vbirjuko/Bargraph_thermometer/bt_term_sch.png

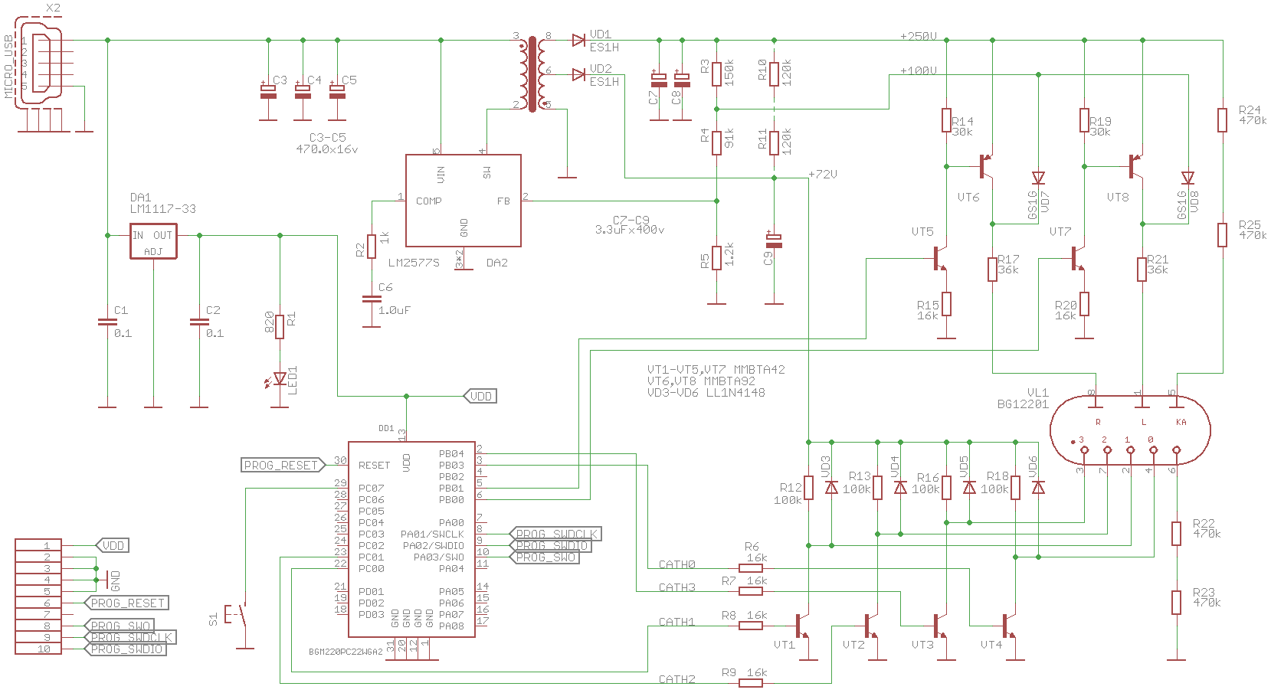
bt_term_sch.png
