vbirjuko/Bargraph_thermometer/transf.png

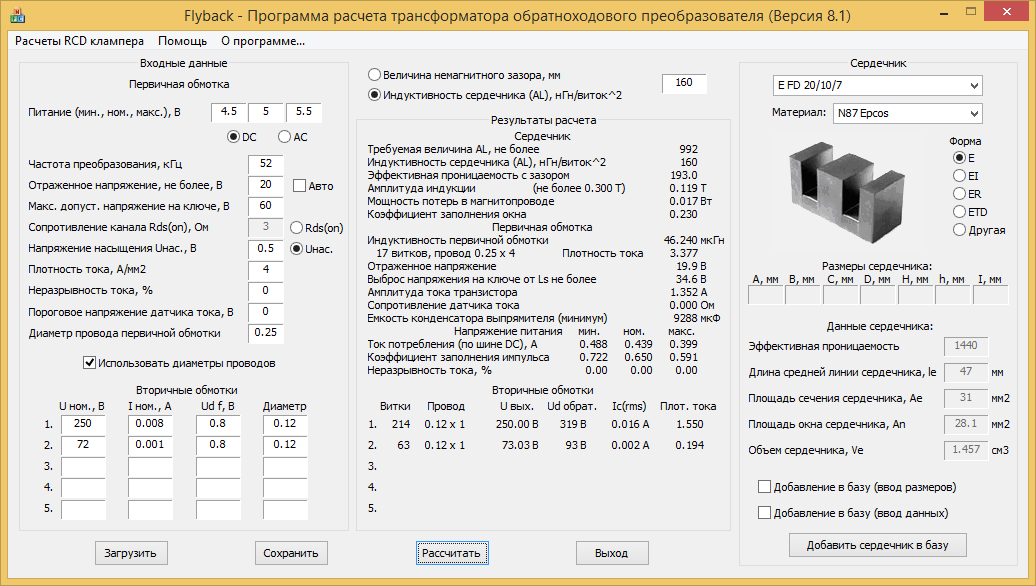
transf.png
