vbirjuko/Bargraph_thermometer/thermo_single.brd

## EAGLE design thermo_single.brd (2021-09-19)

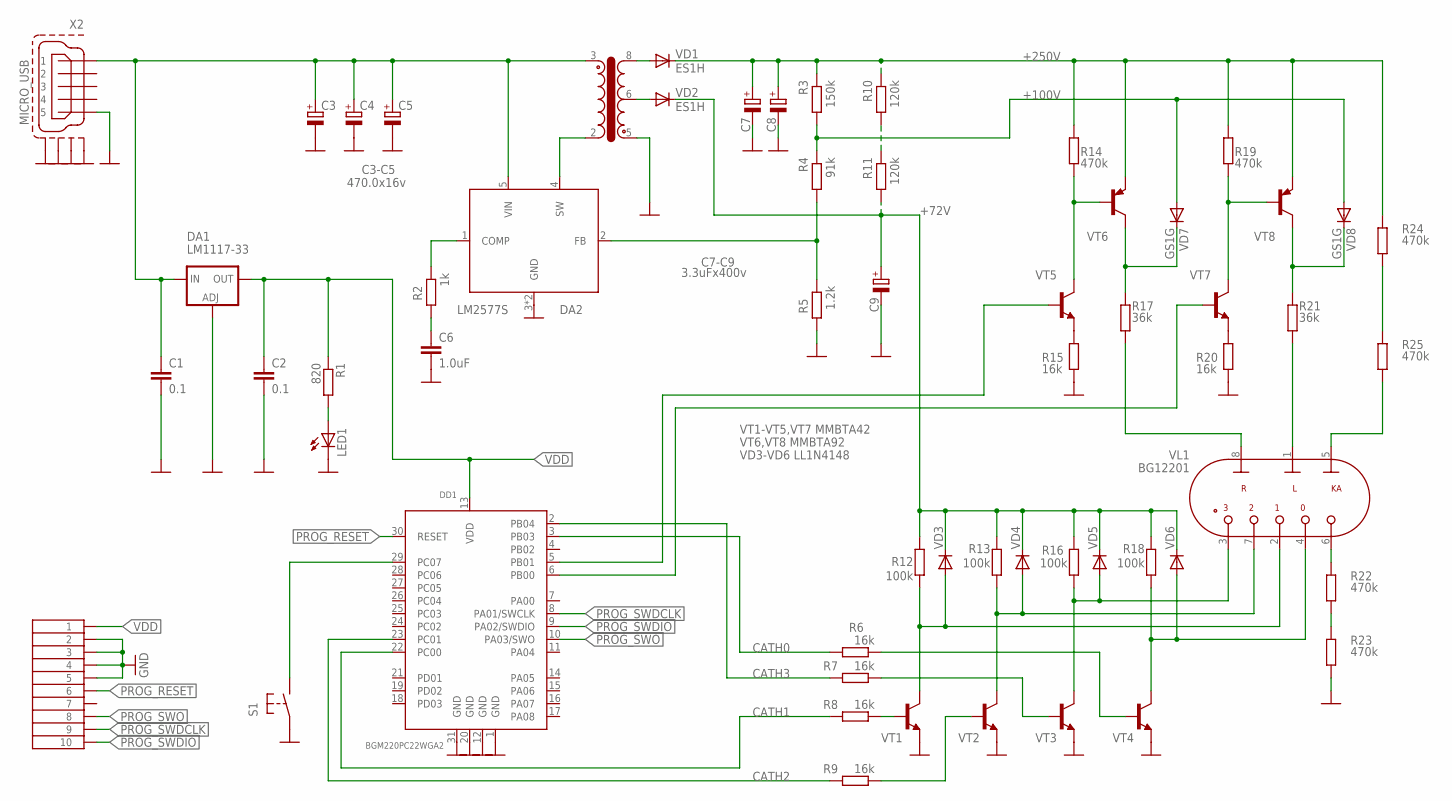
[picture p3: schematic thermo_single.sch]

Parts:
C1, C2: 0.1; C0805
C3, C4, C5: 470.0x16v; PANASONIC_G
C6: 1.0uF; C1206
C7, C8, C9: 3.3uFx400v; PANASONIC_G
DA1: LM1117-33; SOT223
DA2: LM2577S; TO263-5
DD1: BGM220PC22WGA2; BGM13P22F512GEV2
LED1: LEDP-LCC-2; P-LCC-2
R1: 820; R0805
R2: 1k; R0805
R3: 150k; R0805
R4: 91k; R0805
R5: 1.2k; R0805
R6, R7, R8, R9, R15, R20: 16k; R0805
R10, R11: 120k; R0805
R12, R13, R16, R18: 100k; R0805
R14, R19, R22, R23, R24, R25: 470k; R0805
R17, R21: 36k; R0805
S1: 10-XXPTS636SJ25; PTS636SJ25
T1: TRANSFFB; EFD20-8
VD1, VD2: ES1H; DO-214AC
VD3, VD4, VD5, VD6: LL4148; SOD80C
VD7, VD8: GS1G; DO-214AC
VL1: BG12201
VT1, VT2, VT3, VT4, VT5, VT7: mmbta42; SOT23-BEC
VT6, VT8: mmbta92; SOT23-BEC
X1: PINHEAD2X5; DS1031-08-2*5P8BS-4-1
X2: MICRO_USB; MICRO_USB_MOLEX

Connections:
+5V: C1.1, C3.+, C4.+, C5.+, DA1.3 (IN), DA2.5 (VIN), T1.3, X2.1
+72V: C9.+, R11.2, R12.2, R13.2, R16.2, R18.2, VD2.1 (C), VD3.C, VD4.C, VD5.C, VD6.C
+100V: R3.2, R4.1, VD7.2 (A), VD8.2 (A)
+250V: C7.+, C8.+, R3.1, R10.1, R14.2, R19.2, R24.2, VD1.1 (C), VT6.E, VT8.E
ANODE0: DD1.5 (PB01), VT5.B
ANODE1: DD1.6 (PB00), VT7.B
CATH0: DD1.3 (PB03), R6.2
CATH1: DD1.22 (PC00), R8.2
CATH2: DD1.23 (PC01), R9.2
CATH3: DD1.2 (PB04), R7.2
CH1ANODE: R21.1, VL1.1 (LA)
CH2ANODE: R17.1, VL1.8 (RA)
GND: C1.2, C2.2, C3.-, C4.-, C5.-, C6.2, C7.-, C8.-, C9.-, DA1.1 (ADJ), DA2.3 (GND), DA2.6 (GND), DD1.1 (GND), DD1.12 (GND), DD1.20 (GND), DD1.31 (GND), LED1.C, R5.2, R15.1, R20.1, R23.1, S1.P$1, T1.5, VT1.E, VT2.E, VT3.E, VT4.E, X1.2, X1.3, X1.4, X1.5, X2.5, X2.P$1 (S1), X2.P$2 (S2), X2.P$4 (S3), X2.P$5 (S4)
KA_ANODE: R25.1, VL1.5 (KA_A)
KEY: DD1.29 (PC07), S1.P$2 (S)
unnamed: DA2.4 (SW), T1.2
unnamed: R22.2, VL1.6 (KA_C)
unnamed: R22.1, R23.2
unnamed: DA2.2 (FB), R4.2, R5.1
unnamed: C6.1, R2.2
unnamed: DA2.1 (COMP), R2.1
unnamed: R15.2, VT5.E
unnamed: R20.2, VT7.E
unnamed: R14.1, VT5.C, VT6.B
unnamed: R10.2, R11.1
unnamed: R19.1, VT7.C, VT8.B
unnamed: R8.1, VT1.B
unnamed: R7.1, VT3.B
unnamed: R6.1, VT4.B
unnamed: R9.1, VT2.B
unnamed: R17.2, VD7.1 (C), VT6.C
unnamed: R21.2, VD8.1 (C), VT8.C
unnamed: T1.6, VD2.2 (A)
unnamed: T1.8, VD1.2 (A)
unnamed: R24.1, R25.2
unnamed: LED1.A, R1.2
PH1CATHODE: R12.1, VD3.A, VL1.2 (C1), VT1.C
PH2CATHODE: R13.1, VD4.A, VL1.7 (C2), VT2.C
PH3CATHODE: R16.1, VD5.A, VL1.3 (C3), VT3.C
PROG_RESET: DD1.30 (RESET), X1.6
PROG_SWDCLK: DD1.8 (PA01/SWCLK), X1.9
PROG_SWDIO: DD1.9 (PA02/SWDIO), X1.10
PROG_SWO: DD1.10 (PA03/SWO), X1.8
RESETCATHODE: R18.1, VD6.A, VL1.4 (CR), VT4.C
VDD: C2.1, DA1.4 (OUT), DD1.13 (VDD), R1.1, X1.1

Notes on the sheet:
C3-C5
VT1-VT5,VT7 MMBTA42
VT6,VT8 MMBTA92
C7-C9
VD3-VD6 LL1N4148

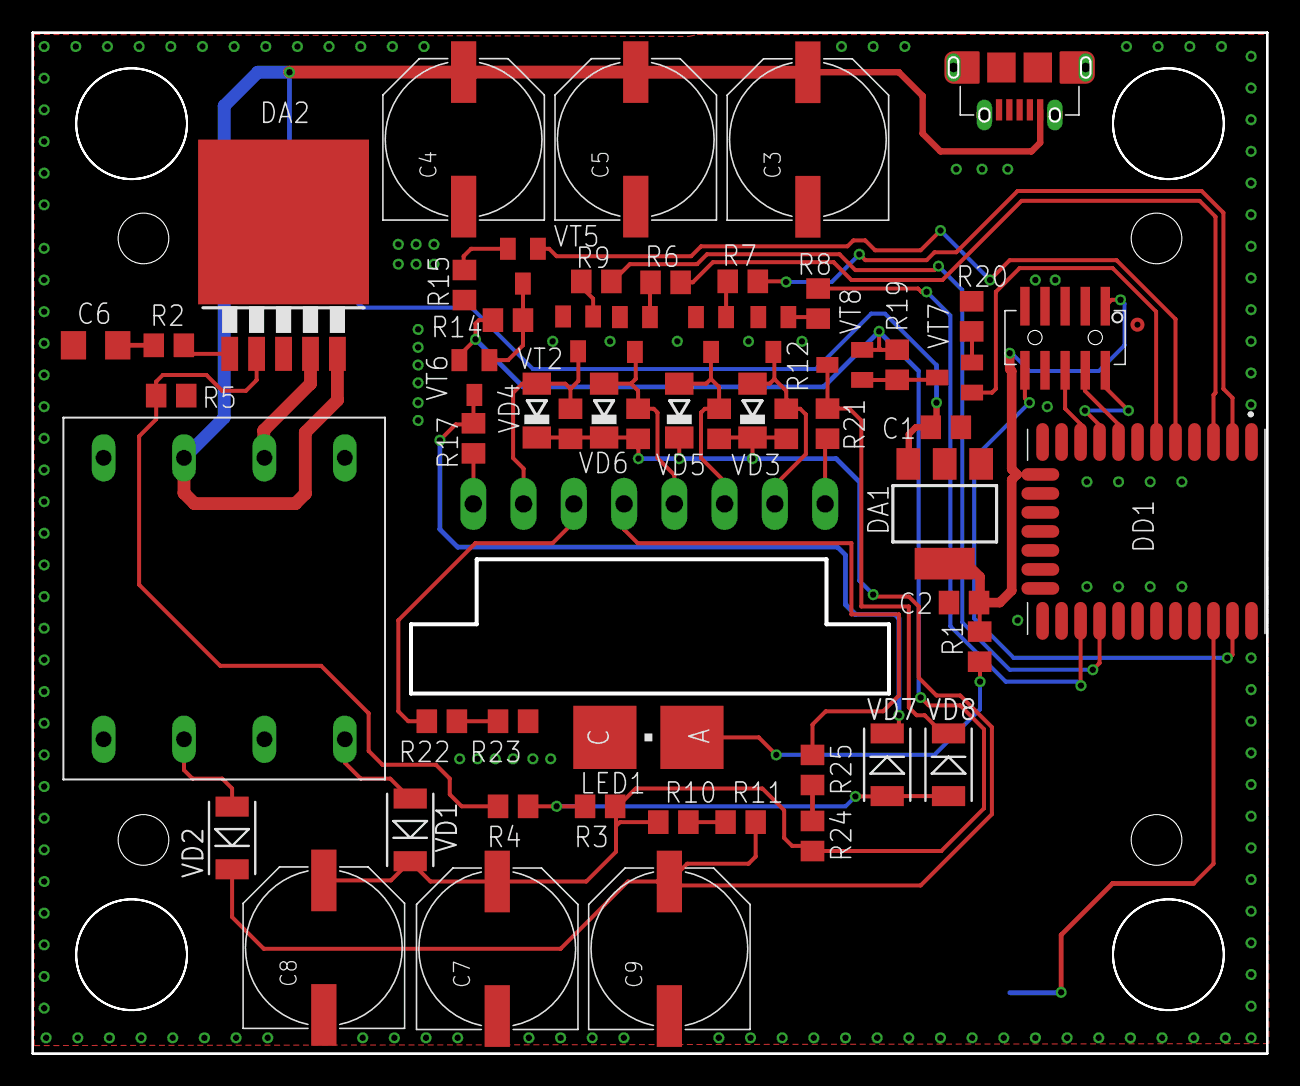
[picture p4: board thermo_single.brd from above]

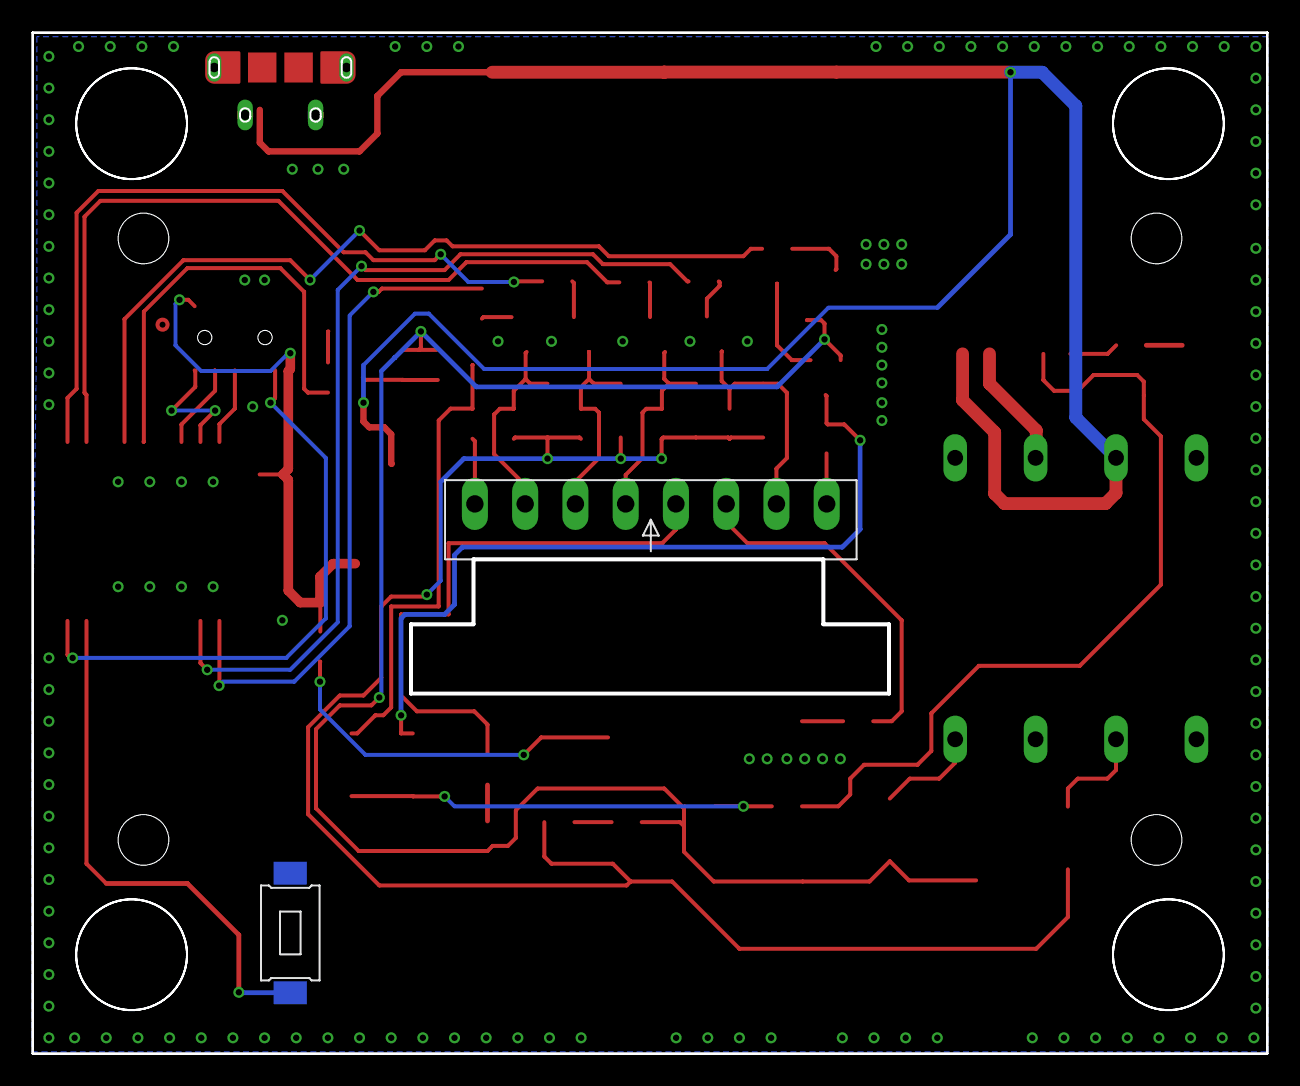
[picture p5: board thermo_single.brd from below]

Board: 2 copper layers, 78.0 x 64.5 mm, 61 parts (2 on the bottom side), 45 nets.

Other parts of the board:
U$1, U$5: 50-200-11
