vbirjuko/Bargraph_thermometer/common/local_temp.h

/*
 * local_temp.h
 *
 *  Created on: 13 апр. 2021 г.
 *     Author: Владимир Бирюков
 */

#ifndef LOCAL_TEMP_H_
#define LOCAL_TEMP_H_

void request_local_temp(unsigned int count);
int get_local_temp(void);


#endif /* LOCAL_TEMP_H_ */
