vbirjuko/Bargraph_thermometer/common/server.h

/***************************************************************************//**
 * @file
 * @brief Application interface provided to main().
 *******************************************************************************
 * # License
 * <b>Copyright 2020 Silicon Laboratories Inc. www.silabs.com</b>
 *******************************************************************************
 *
 * The licensor of this software is Silicon Laboratories Inc. Your use of this
 * software is governed by the terms of Silicon Labs Master Software License
 * Agreement (MSLA) available at
 * www.silabs.com/about-us/legal/master-software-license-agreement. This
 * software is distributed to you in Source Code format and is governed by the
 * sections of the MSLA applicable to Source Code.
 *
 ******************************************************************************/

#ifndef SERVER_H
#define SERVER_H

/**************************************************************************//**
 * Application Init.
 *****************************************************************************/
void app_init(void);

/**************************************************************************//**
 * Application Process Action.
 *****************************************************************************/
void app_process_action(void);

void server_on_event(sl_bt_msg_t *evt);

#define DEVICE_MODE_REMOTE  0x01
#define DEVICE_MODE_SAME    0x02
#define DEVICE_MODE_LOCAL_LEFT  0x04
#define DEVICE_MODE_LOCAL_RIGHT 0x08

extern unsigned int device_mode;

#endif
