vbirjuko/Bargraph_thermometer/common/visualise.h

/*
 * visualise.h
 *
 *  Created on: 29 июн. 2021 г.
 *      Author: wl
 */

#ifndef VISUALISE_H_
#define VISUALISE_H_

#define ABSOLUTE_ZERO (-273)

void show_temp (int temp, unsigned int right);
void visualise_iterate(void);

#endif /* VISUALISE_H_ */
